Curious-Utkarsh/ROS2_SCARA_WS/scara_description/models/Yellow_Box/meshes/Yellow_Box.stl

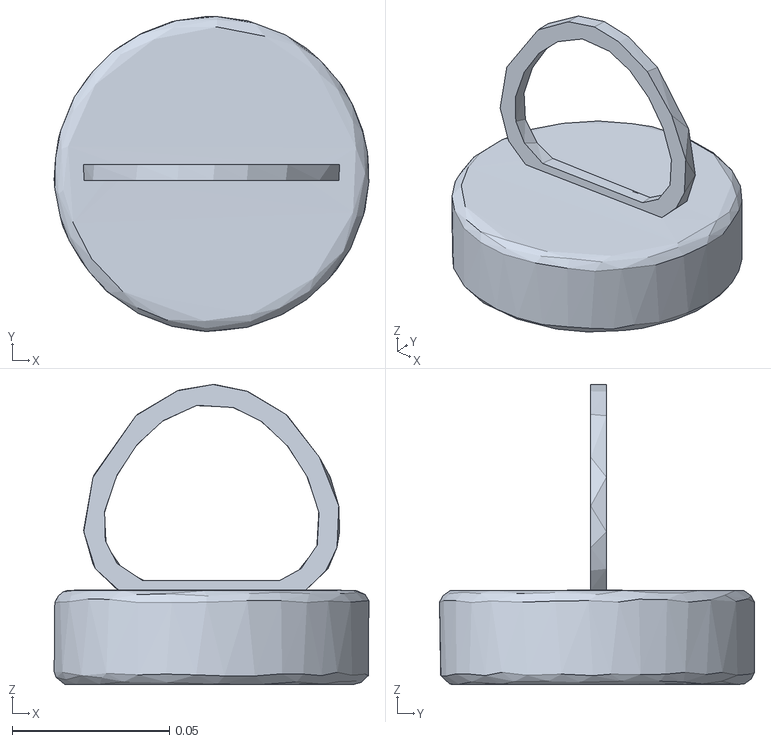
[picture p1: CAD file, 2026-07-27]
scara_description/models/Yellow_Box/meshes/Yellow_Box.stl
0.0999 x 0.1 x 0.0953
