Curious-Utkarsh/ROS2_SCARA_WS/(commit log)

2026-07-27 converyor belt added
2026-07-27 conveyor belt setup fixed
2026-10-20 docs: rewrite README with demo and run guide
    Replaces the 3-line stub. Adds overview, YouTube/LinkedIn/Instagram demo links, key features, hardware, system diagram, package list, build/run commands, engineering notes, related repos and credits (Cults3D model, pymoveit2). Keeps the rviz_common pin note from the old README.
2026-10-22 README: link the portfolio case study
